git109/CNC_Vac_Pump/stm32/zephyrwb/UI_WIDGET_SPEC.html

# SquareLine UI — per-widget rebuild spec For the LVGL-9 fresh project · SquareLine Studio 1.6.1

Values pulled from the existing project (source/Vac_Gauge_V2/src/ui_lvgl/ui_Screen1.c + Sm_Disp.spj). Recreate the widgets in this order (top → bottom = back → front z-order) and keep the names exact.

## How the SLS 1.6.1 Inspector is laid out

A selected widget's Inspector has these sections. Each value below is tagged with where it goes:

- PROPSWidget Properties (top): the Name + widget-specific fields — Image: Asset, Rotation, Pivot X/Y, Scale; Label: Text.
- TRANSFORMX, Y, Width, Height, Align (position/size; X/Y in px).
- STYLEStyle Settings (bottom): add a local style to a Part (Main / Indicator), then set Background color, Radius, Text (font/color/spacing).

Every widget uses Align = CENTER, so the Transform X/Y are offsets from screen center (negative Y = up, negative X = left). "Size = content" → leave Width/Height on content so the image keeps its PNG size.

## Widgets (create in this order)

### Screen: Screen1

- STYLEMain part → Background color #000000 (black), opacity 255.

### 1. GaugeFace — Image

- PROPSAsset = Small_Gauge_Scale.png
- TRANSFORMAlign CENTER, X 0, Y -6, size content

### 2. Spinner1 — Spinner (decorative — firmware never drives it; optional)

- TRANSFORMAlign CENTER, X 20, Y 49, Width 30, Height 30
- STYLEMain part → Arc → Width 5; Indicator part → Arc → Width 5
- FLAGSClickable off

No Time/Angle fields in SLS 1.6.1. LVGL 9 moved the spin time/arc out of the spinner constructor, so SquareLine no longer exposes them — the animation runs at its built-in defaults. Place the widget and move on. You can even skip it entirely; nothing in the firmware references it.

### 3. ledDarkImage — Image

- PROPSAsset = Dark_LED.png
- TRANSFORMAlign CENTER, X 42, Y 5, size content

### 4. ledRedImage — Image (create AFTER ledDarkImage so it stacks on top)

- PROPSAsset = Red_LED.png
- TRANSFORMAlign CENTER, X 42, Y 5, size content

### 5. Needle — Image

- PROPSAsset = Small_Gauge_Needle.png; Rotation 0; Pivot X 78 / Pivot Y 15
- TRANSFORMAlign CENTER, X -32, Y 35, size content

### 6. vacLabel — Label

- PROPSText = 30.0
- TRANSFORMAlign CENTER, X 0, Y -24, size content
- STYLEMain part:
  - Text → Font courierBold, Color #BEDBBE, Letter space -2, Line space 0
  - Background → Color #454545, opacity 255
  - Radius 5

### 7. redBugImg — Image

- PROPSAsset = red_bug_.png (trailing underscore); Rotation -45.0 (°); Pivot X 8 / Pivot Y 119
- TRANSFORMAlign CENTER, X 0, Y -107, size content

### 8. grnBugImg — Image

- PROPSAsset = grn_bug_.png (trailing underscore); Rotation -90.0 (°); Pivot X 8 / Pivot Y 119
- TRANSFORMAlign CENTER, X 0, Y -107, size content

## Font: courierBold — two steps

Copying the TTF into Assets is not enough — it only makes it a source. You must then generate the font in the Font Manager, or it won't appear in the label's Font dropdown (you'll only see the built-in Montserrat sizes).

1. Add the source: drop Courier_BOLD.ttf into the project's assets/ (Assets → Fonts). Makes it selectable in the Font Manager; does not create a usable font yet.
2. Generate it: open Panels → Font Manager → Create New Font with:

Field | Value | Note
Font Name | courierBold
Select Font Asset | Courier_BOLD.ttf | from the dropdown
Font Size | 30
Bpp | 4 | ⚠️ original was 8 bpp — LVGL 9 rejects 8-bpp; 8 also blocks generation
Range | 0x20-0x7F | ASCII printable

3. Click Create Font → it appears under Created Fonts.
4. Assign it: vacLabel → STYLE → Text → Font → courierBold.

## Images to import

Assets → Images → Add, from source/SquareLine_VacDisp/assets/. Use exactly these 6; ignore the near-duplicates (Red_Bug.png, Small_Gauge_Needle copy.png, the *_.png scale variant, Red_Bug-17X26.png):

Widget | PNG
GaugeFace | Small_Gauge_Scale.png
ledDarkImage | Dark_LED.png
ledRedImage | Red_LED.png
Needle | Small_Gauge_Needle.png
redBugImg | red_bug_.png
grnBugImg | grn_bug_.png

## Notes

- Rotation units: SLS shows degrees with one decimal (-45.0) — matches the old code's 0.1° integer (-450). Enter the degree value.
- Pivot only matters on rotating images (Needle, redBugImg, grnBugImg); leave it default on the rest.
- The firmware drives, at runtime: vacLabel text, Needle rotation, redBugImg / grnBugImg rotation, and ledRedImage show/hide — all by the exact names above; the values here are just the starting layout.

Once exported to stm32/zephyrwb/src/ui/, ping me and I'll wire ui_init() + those runtime calls into main.c for LVGL 9.
