git109/CNC_Vac_Pump/stm32/zephyrwb/WIRING.html

# CNC Vacuum Pump Controller — Wiring P-NUCLEO-WB55 (nucleo_wb55rg) · ST Morpho headers (CN7/CN10) · GC9A01 round LCD

Silk = label printed on the GC9A01 module · Morpho = CN7/CN10 connector-pin to land the wire on · STM32 = MCU port · (Arduino) = same MCU pin's Arduino-header alias, for cross-reference · Wire = JXI pigtail color. LCD rows are shaded.

Function | Silk | Morpho | STM32 | Arduino | Wire
Vac sensor (ADC) | — | CN7-34 | PA0 (ADC1_IN5) | A3 | —
Pump relay (active-low) | — | CN7-36 | PC3 | A4 | —
Alarm relay (active-low) | — | CN7-38 | PC2 | A5 | —
Heartbeat LED | — | onboard LD2 | PB0 (green) | — | —
Encoder A | — | CN10-33 | PC6 | D2 | —
Encoder B | — | CN10-31 | PA10 | D3 | —
Encoder switch | — | CN10-29 | PC10 | D4 | —
LCD SCLK | SCL | CN10-11 | PA5 | D13 | Wht
LCD MOSI (Din) | SDA | CN10-15 | PA7 | D11 | Yel
LCD CS | CS | CN10-17 | PA4 | D10 | Blu
LCD DC | DC | CN10-19 | PA9 | D9 | Grn
LCD RST | RES | CN10-21 | PC12 | D8 | Org
LCD backlight | BLK | CN7-32 | PA1 | A2 | Pur
LCD VCC | VCC | CN7-16 | 3V3 | — | Red
LCD GND | GND | CN7-20 | GND | — | Blk
Sensor Vs (supply) | — | CN7-18 | 5V | — | —

Using the ST Morpho headers — read this. The Morpho connectors (CN7, CN10) bring out every MCU pin, so they're less foolproof than the Arduino header. Electrically it's the same pin either way — nothing in the firmware/overlay changes — but physically:

• Count carefully. Each connector is 2×19 = 38 pins: odd column (1,3,5…) one side, even (2,4,6…) the other. Pin 1 is silk-marked. Analog + power (A0–A5, 5 V, 3V3) are on CN7; digital D0–D15 are on CN10.

• Avoid the debug/system pins the Arduino header hid: PA13/PA14 (SWD), NRST, PH3/BOOT0 — wiring to these can break flashing. And leave PA2/PA3 (CN10-35/37, D1/D0) alone — they're the ST-LINK console VCP.

• Solder-bridge-shared pads: PA7 (CN10-15, shares w/ PA10), PA4 (CN10-17, shares w/ PB10), PA1 (CN7-32, shares w/ PB6). The board defaults to the pin we use — don't move the solder bridges.

Power the LCD from 3V3, not 5V. The module's VCC must match the 3.3 V signal level — a 5 V-powered panel driven by 3.3 V logic typically shows blank/garbled.

No MISO. The panel is write-only (only SDA data-in), so the SPI bus is SCK + MOSI only and CS is a GPIO.

BLK is active-high, on by default (internal pull-up to 3.3 V). Firmware drives PA1 high to enable it; grounding BLK suspends the backlight.

## Vacuum sensor front-end (analog)

NXP MPXV4115V (5 V ratiometric part) → resistor divider → the 3.3 V ADC. The divider both scales the 0.2–4.6 V output into range and protects the ADC pin (never wire the raw sensor output to the MCU).

Node | Connect to | Notes
Sensor Vs (supply) | Nucleo 5V (CN7-18) | MPXV4115V needs ~5 V; output is ratiometric to it
Sensor GND | GND (CN7-20)
Sensor Vout → node Vac_Sensor | top of R1; C1 & C3 to GND | 0.2–4.6 V raw
C1 10 µF, C3 100 pF | Vac_Sensor → GND | supply/noise filtering on the sensor node
R1 5 kΩ | Vac_Sensor → Vacuum_Sig | divider top
R2 10 kΩ | Vacuum_Sig → GND | divider bottom
Vacuum_Sig (tap) | CN7-34 / PA0 (ADC1_IN5) | 0.13–3.07 V into the ADC

  MPXV4115V Vout
  (0.2..4.6V)
       │  Vac_Sensor
       ├──────────────┬───────────────┐
       │              │               │
      ─┴─ C1         ─┴─ C3          [R1] 5k
      10uF          100pF             │
       │              │               ├──────►  Vacuum_Sig ──►  CN7-34 / PA0
      GND            GND            [R2] 10k     (0.13..3.07V)
                                      │
                                     GND

Divider math: ratio = 10k/(5k+10k) = 0.667 → max 4.6 V × 0.667 = 3.07 V (93% of the 3.3 V full scale, safely under the 3.6 V pin max). Source impedance = 5k∥10k = 3.3 kΩ, handled by the 47.5-cycle ADC sample time in the overlay.

Calibration: the firmware's raw→inHg map still uses the ESP32's 4090 full scale — retune to the real min/max counts on the WB55 (~3810 at 3.07 V). See the TODO(calibrate…) in src/main.c.

## Notes

- Encoder A/B/SW use internal pull-ups — idle high, each switches to GND.
- Relays are active-low (matches the firmware's On = 0 convention).
- Console + flashing share the single ST-LINK USB (USART1 VCP) — no wiring needed.
