git109/CNC_Vac_Pump/PCB/Vac_Pump_Controller/Vac_Pump_Controller_WB55.pdf

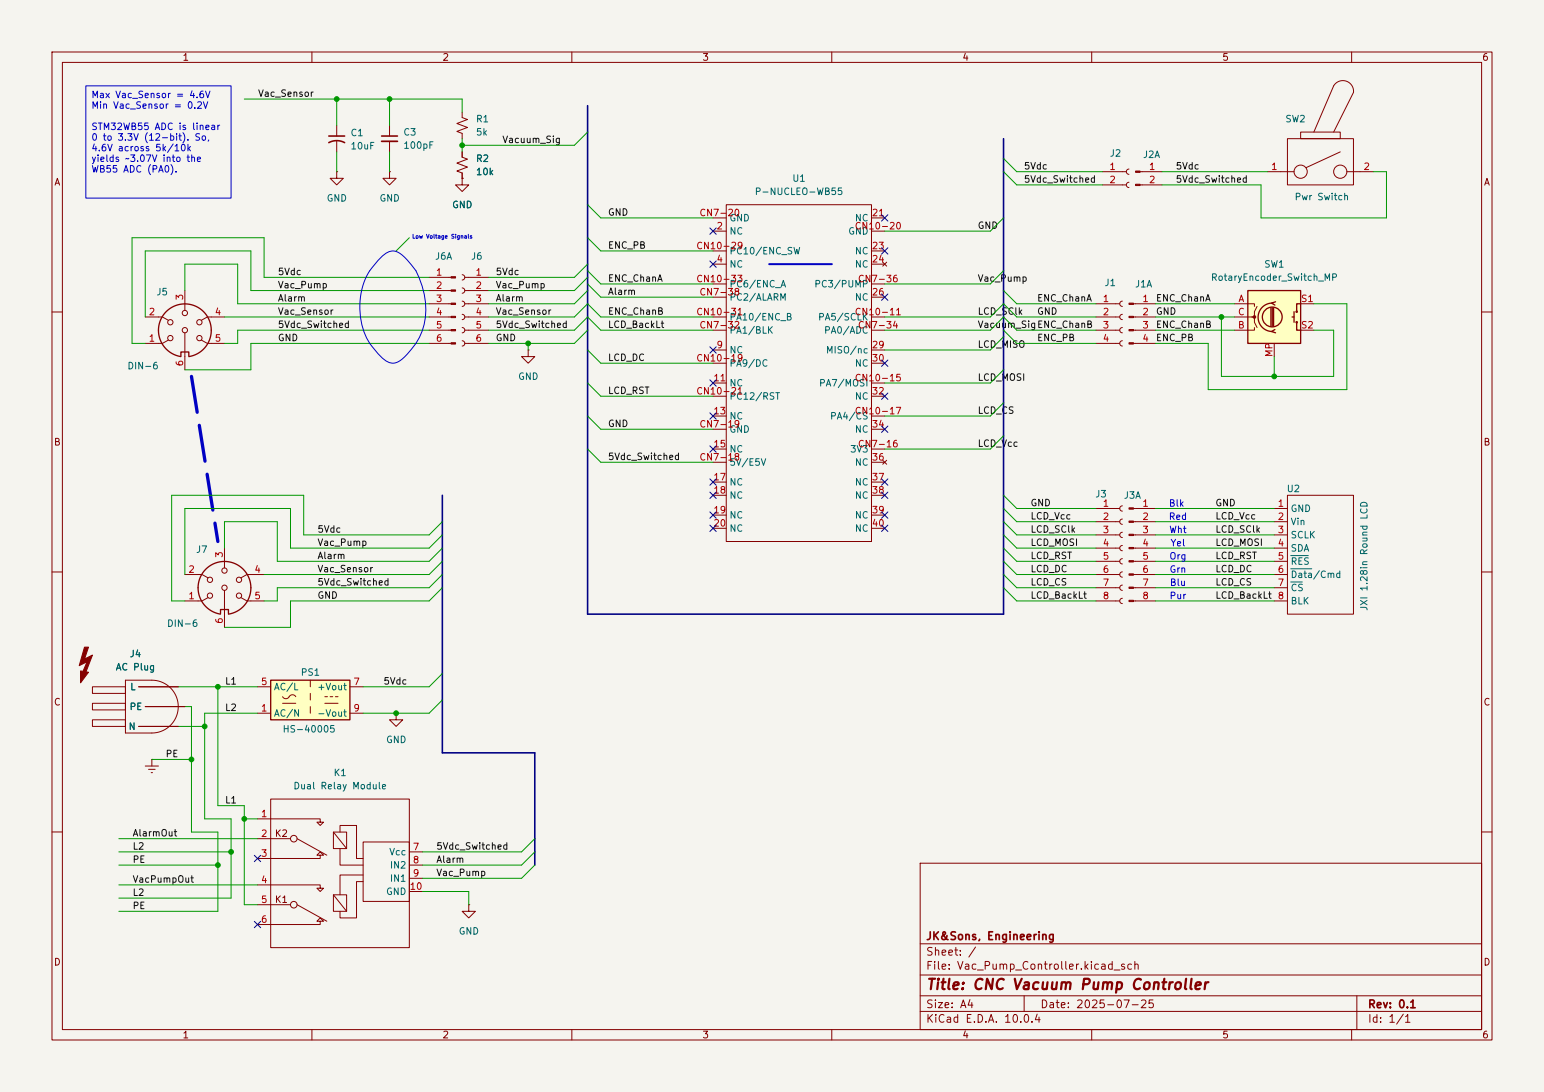
[picture p1: page 1]

Max Vac_Sensor = 4.6V Min Vac_Sensor = 0.2V STM32WB55 ADC is linear 0 to 3.3V (12-bit). So, 4.6V across 5k/10k

JK&Sons, Engineering
Sheet: /
File: Vac_Pump_Controller.kicad_sch
Title: CNC Vacuum Pump Controller

Size: A4 | Rev: 0.1
KiCad E.D.A. 10.0.4 | Id: 1/1
