git109/CNC_Vac_Pump/(commit log)

2026-07-09 Docs: ST Morpho wiring migration + KiCad WB55 swap kit
    [app_state.h, encoder.c, main.c]
2026-07-09 PCB: swap ESP32 WeMos symbol for P-NUCLEO-WB55 (ST Morpho) in schematic
    In-place symbol clone keeps identical pin geometry so every existing wire,
    net-label and no-connect stays attached. Pin names -> WB55 functions, pin
    numbers -> ST Morpho refs (CN7/CN10). Validated: kicad-cli sch erc reports
    40 violations, identical to the pre-swap baseline (zero new). MCU power stays
    on 5Vdc_Switched; MISO kept but marked n/c (write-only panel).
    [Vac_Pump_Controller.kicad_sch]
2026-07-09 PCB: tidy WB55 symbol label placement
    Move the U1 net-labels outward along their existing wire stubs (right column
    +12.7mm, left column -3.8mm) so they clear the longer WB55 pin numbers, and
    remove the redundant 'WB55' watermark that overlapped two pin names. Only label
    positions changed (wires/pins untouched) -> ERC unchanged at 40 (baseline) and
    netlist connectivity verified identical (16 nets on U1, Morpho pin refs intact).
    [Vac_Pump_Controller.kicad_sch]
2026-08-03 EVT1: calibrate vacuum readout + sensor front-end decoupling
    Firmware (stm32/zephyrwb):
    - Compile out CONFIG_VAC_SIM: read the real MPXV4115V on PA0/ADC1_IN5.
    - Two-point calibration of the readout against the VB2200 manifold gauge with
    the fitted 3.94k/6.8k divider: atmosphere = 0 inHg @ 4044 counts, full vacuum
    = 29 inHg @ 709 counts (divider ratio and VREF cancel in the fit).
    - Fix the gauge needle to track the calibrated value on the correct face angle
    (0 inHg at dial start, 30 under vacuum), aligned with the setpoint bugs.
    - Enable CONFIG_LV_COLOR_16_SWAP to fix the GC9A01 RGB565 byte-swap color cast.
    PCB (Vac_Pump_Controller):
    - New Sensor_End hierarchical sheet: 3-pin MPXV4115V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
    [Sensor_End.kicad_sch, Vac_Pump_Controller.kicad_sch]
2026-08-12 Docs: add CLAUDE.md project guide
    Onboarding/reference for resuming work: current EVT1 status and open items,
    tech stack, repo layout (active WB55 firmware vs abandoned ESP32 tree),
    build/flash/console workflow (zephyresp32s3 west topdir, CubeProgrammer-only
    flashing, variable serial device), KiCad-cli validation, firmware architecture,
    and the sensor front-end / calibration constants.
